tarosay/CanSat2025_Sample/README.md

# CanSat2025_Sample
CanSat 2025 サンプルプログラム 

## CanSatテスト基板の発注

JLCPCBに CanSat2025_04_28.zip を使って基板を発注する方法について、以下の動画で説明しています。

[JLCPCBにCanSatテスト基板を発注する動画はこちら](https://www.youtube.com/watch?v=9X-uCuEG0BU)
