tarosay/CanSat2025_Sample/Documents/ArduinoIDEの事前インストール.pdf

## ArduinoIDEのインストール

㈱ビジュアル・テクノロジー研究所
山本三七男

## 事前にインストールしておく

1.ArduinoサイトからArduinoIDEをダウンロードします

https://www.arduino.cc/en/software

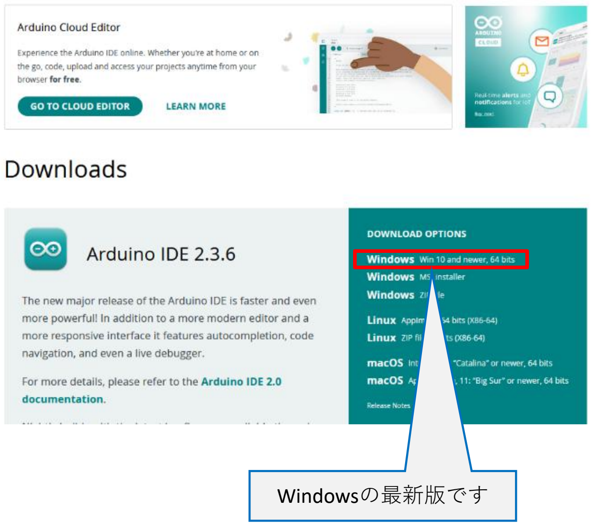
[picture p1: figure]
Windowsの最新版です
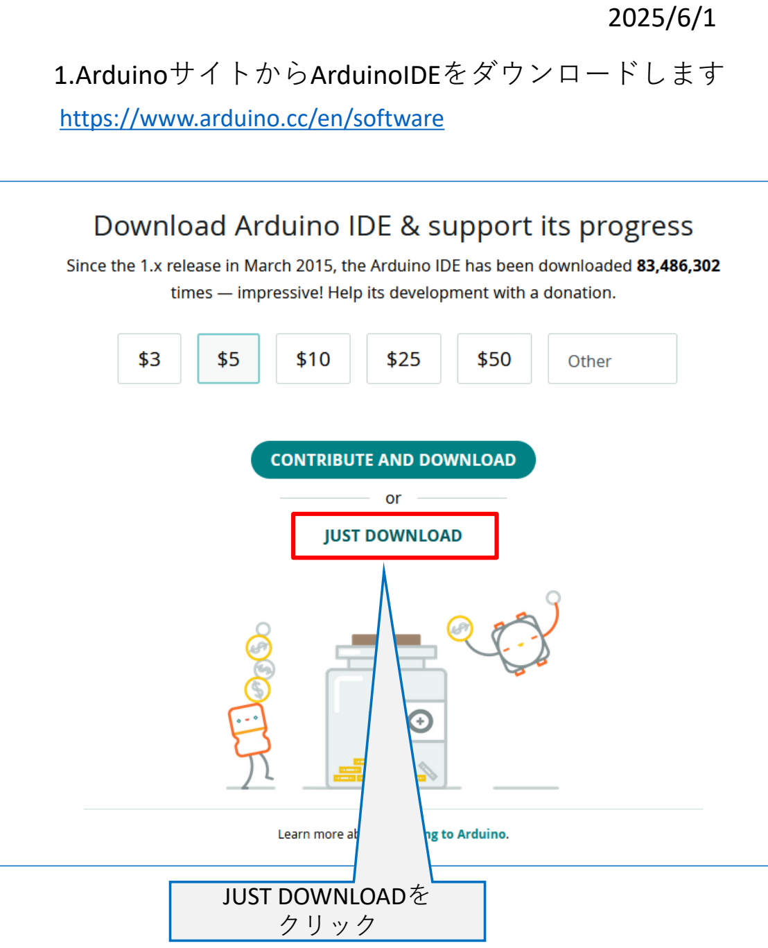
[picture p2: page 3]

JUST DOWNLOADを
クリック

1.ArduinoサイトからArduinoIDEをダウンロードします

https://www.arduino.cc/en/software

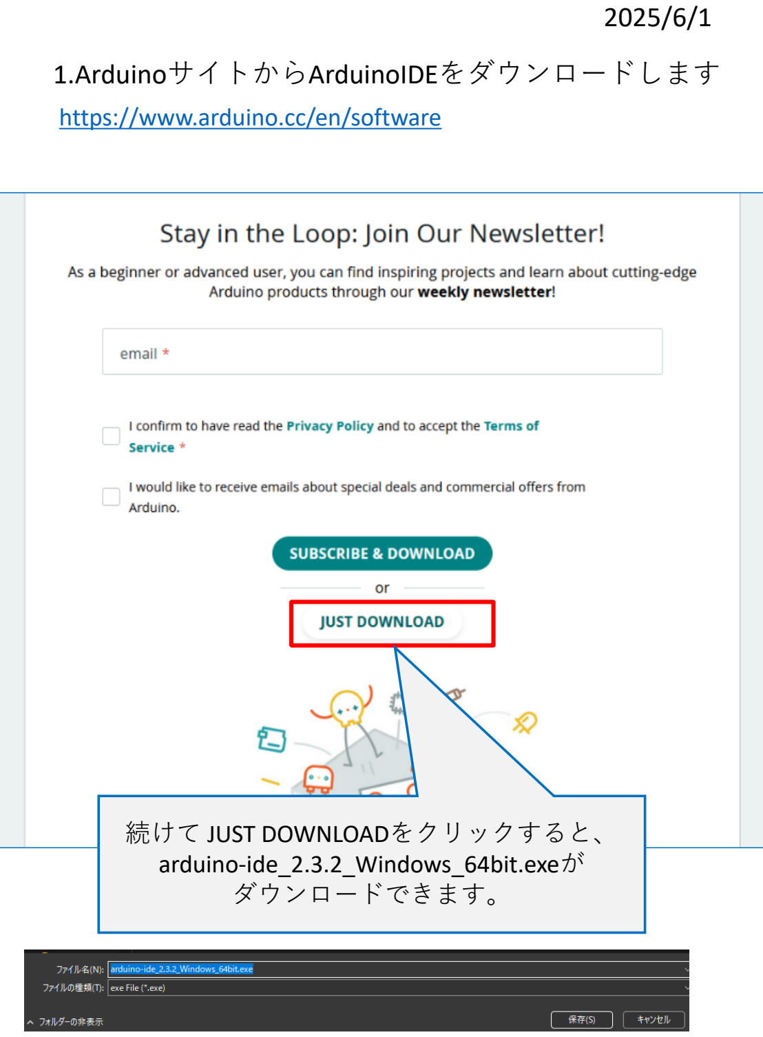
[picture p3: page 4]

続けて JUST DOWNLOADをクリックすると、 arduino-ide_2.3.2_Windows_64bit.exeが ダウンロードできます。

1.ArduinoサイトからArduinoIDEをダウンロードします

https://www.arduino.cc/en/software

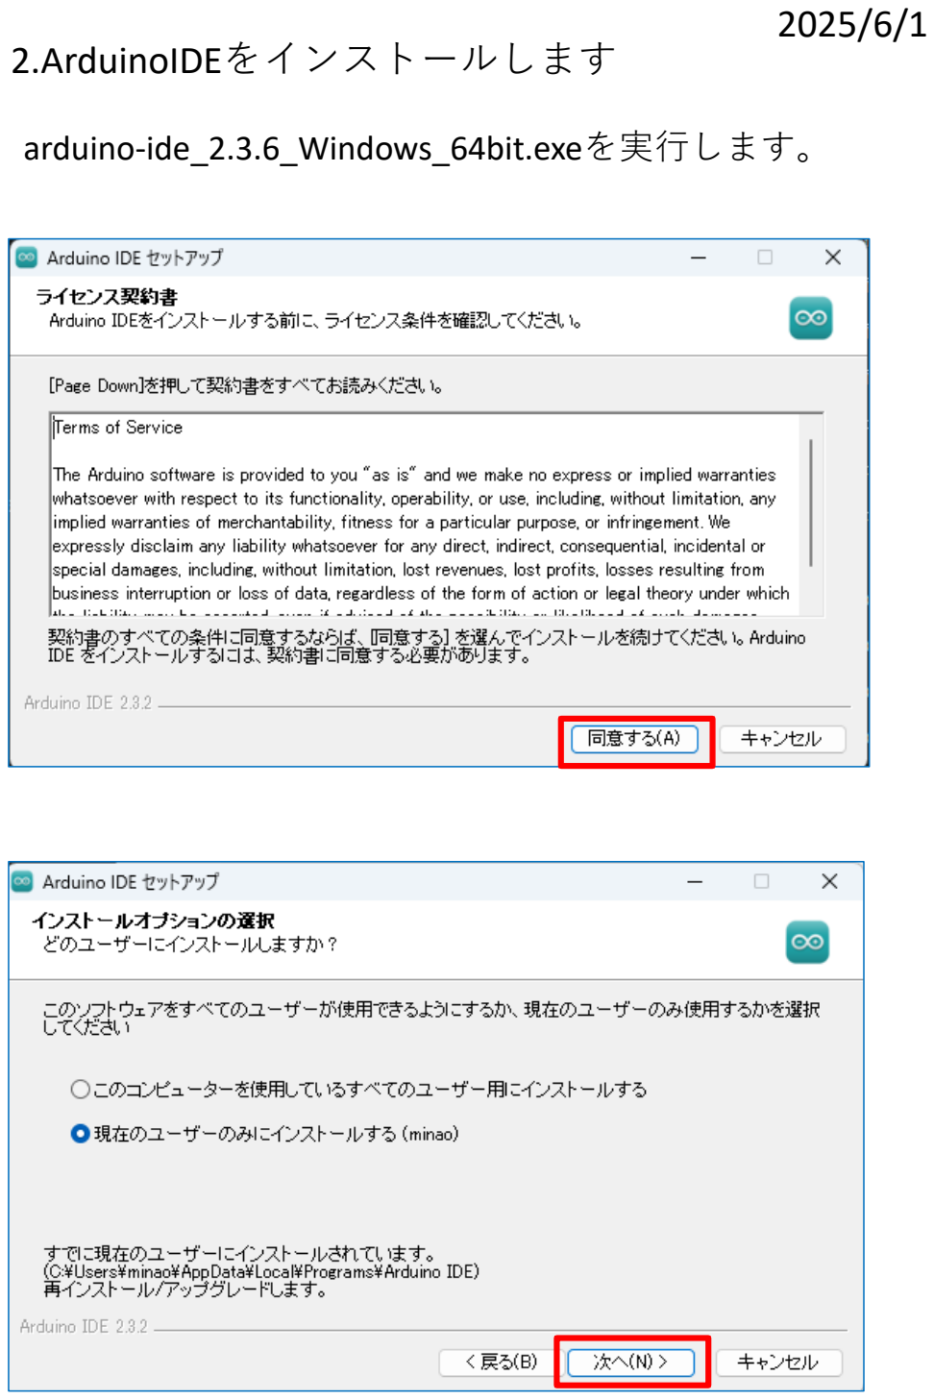
[picture p4: page 5]

2.ArduinoIDEをインストールします

arduino-ide_2.3.6_Windows_64bit.exeを実行します。

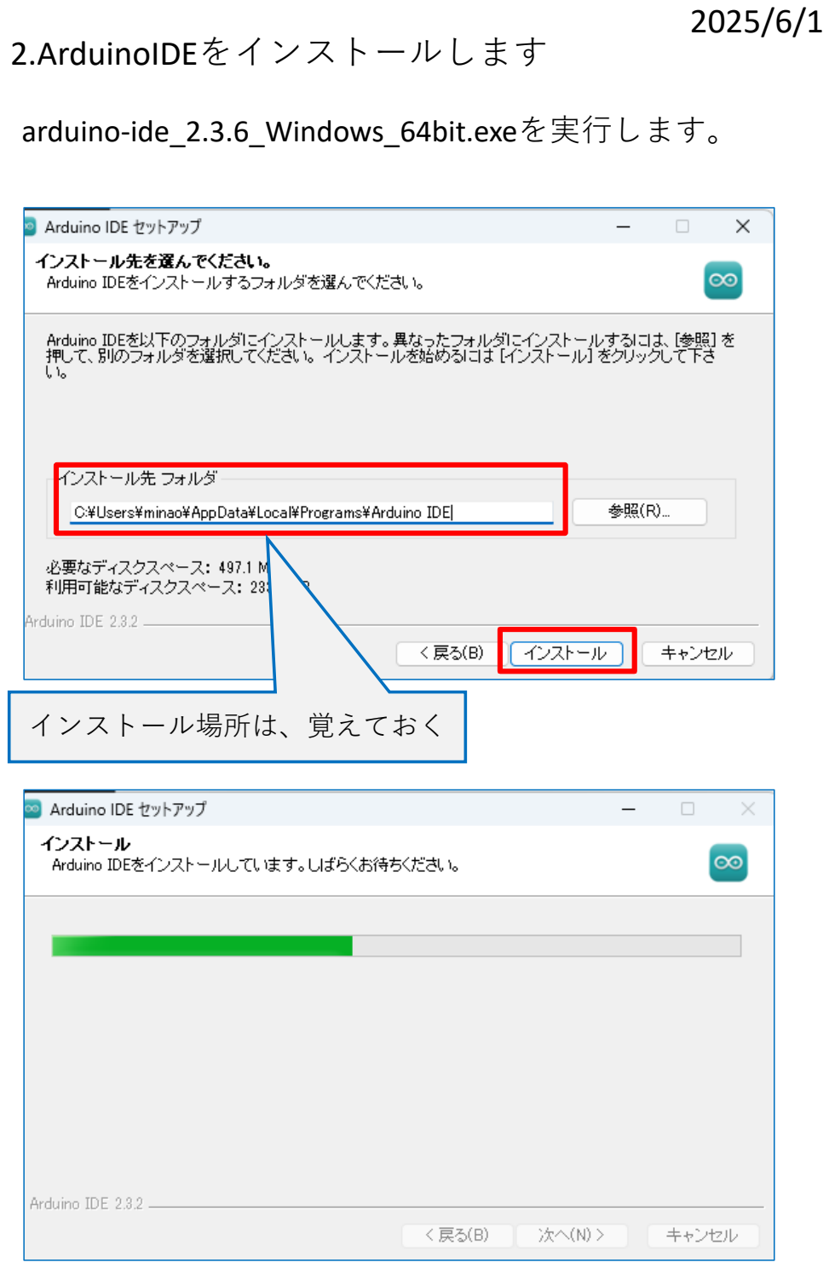
[picture p5: page 6]

2.ArduinoIDEをインストールします

arduino-ide_2.3.6_Windows_64bit.exeを実行します。

インストール場所は、覚えておく

2.ArduinoIDEをインストールします

arduino-ide_2.3.6_Windows_64bit.exeを実行します。

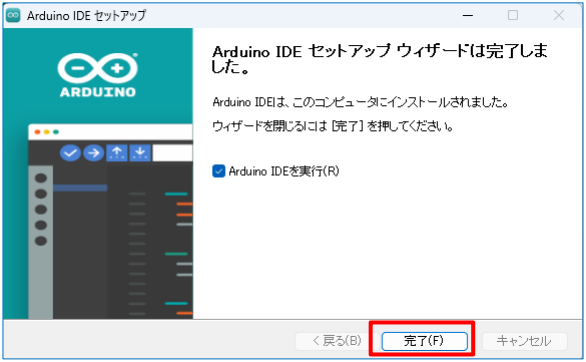
[picture p6: figure]

「完了」を押すと、ArduinoIDEが立ち上がります。

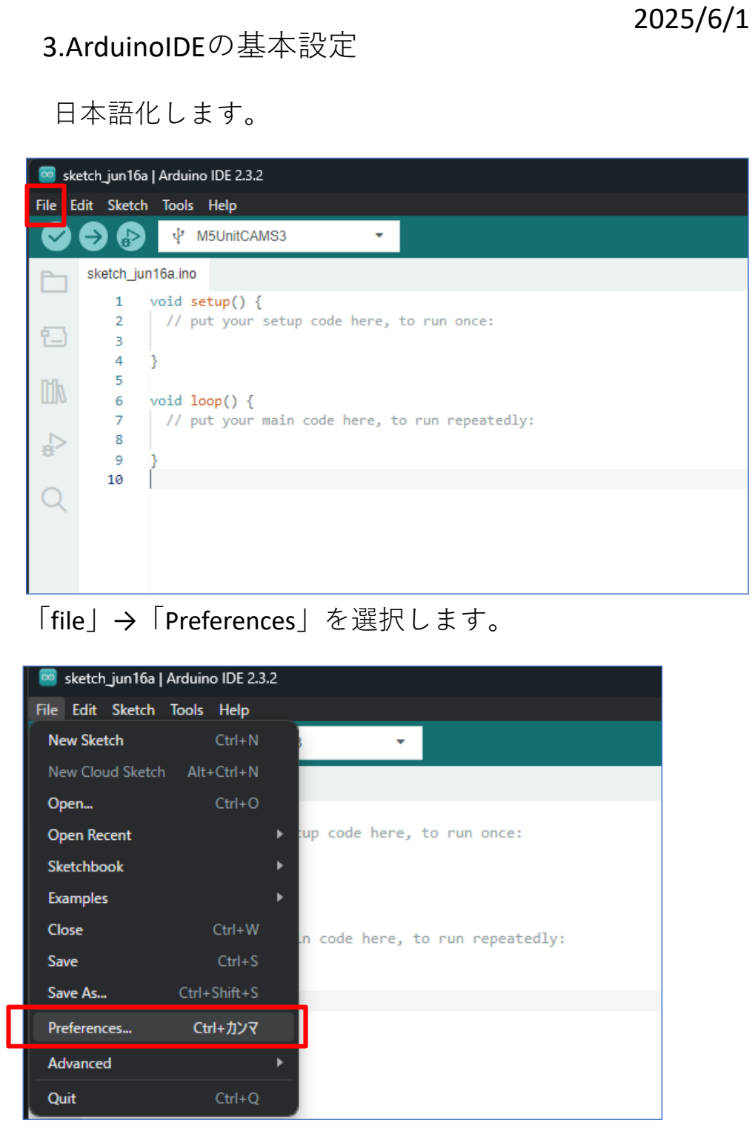
[picture p7: page 8]

3.ArduinoIDEの基本設定

日本語化します。

「file」→「Preferences」を選択します。

3.ArduinoIDEの基本設定

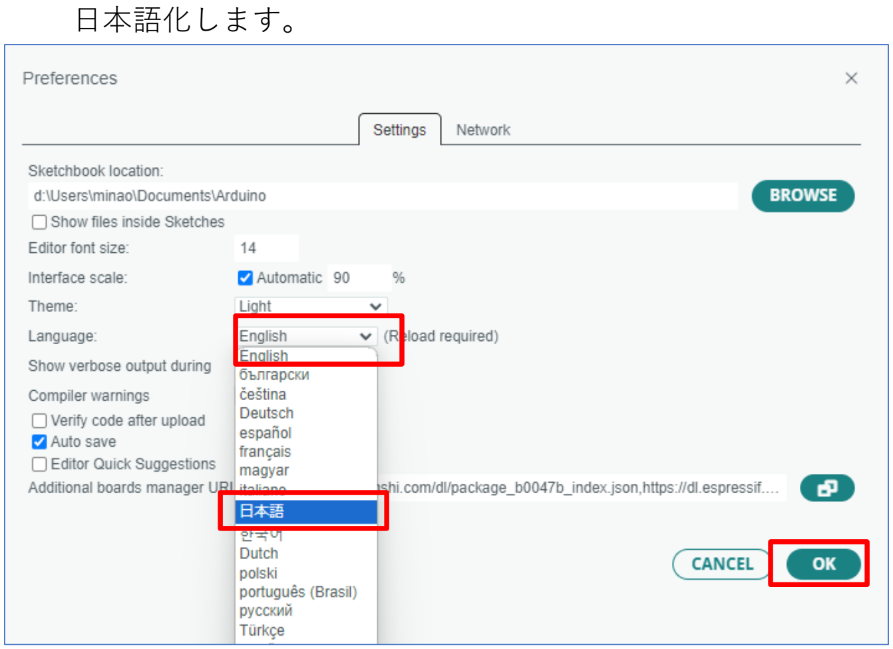
[picture p8: figure]
日本語化します。

「日本語」にして「OK」

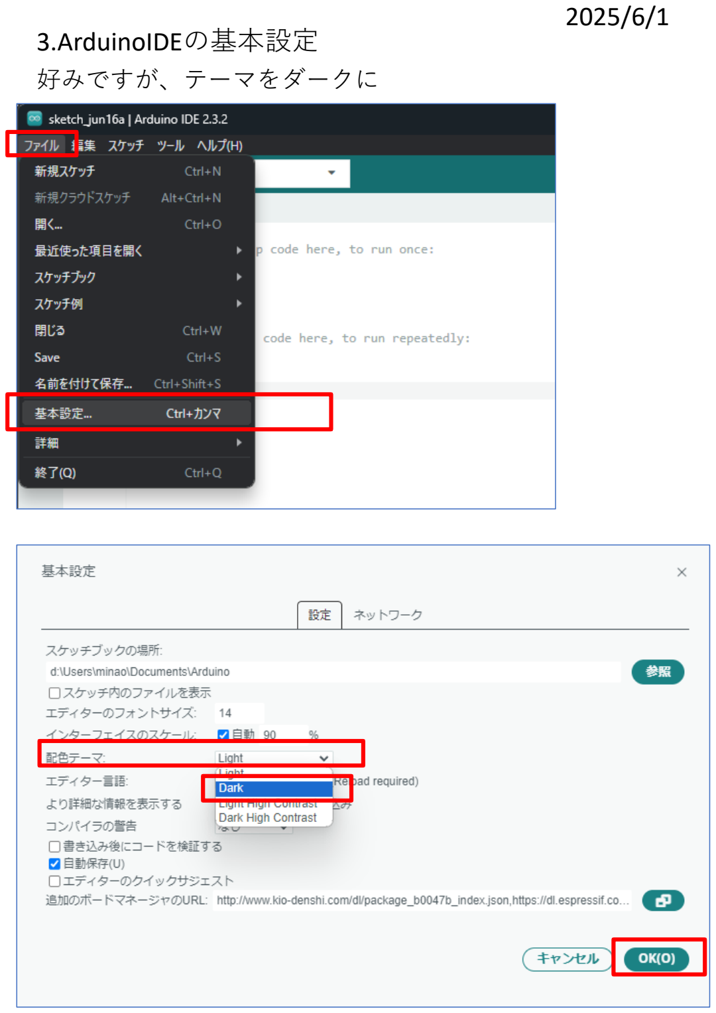
[picture p9: page 10]

3.ArduinoIDEの基本設定
好みですが、テーマをダークに

3.ArduinoIDEの基本設定

より詳細な情報を表示するの「コンパイル」と「書き込
み」にチェックを入れます。

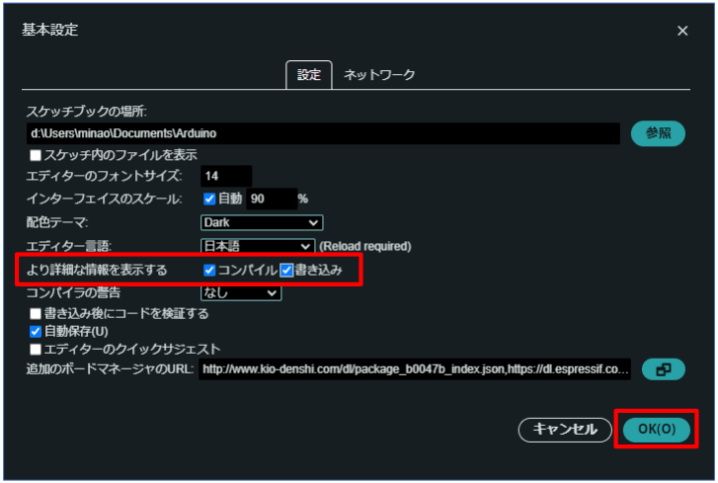
[picture p10: figure]

3.ArduinoIDEの基本設定
追加のボードマネジャのURLに以下を追加する。
https://m5stack.oss-cnshenzhen.aliyuncs.com/resource/arduino/package_m5stack_in dex.json

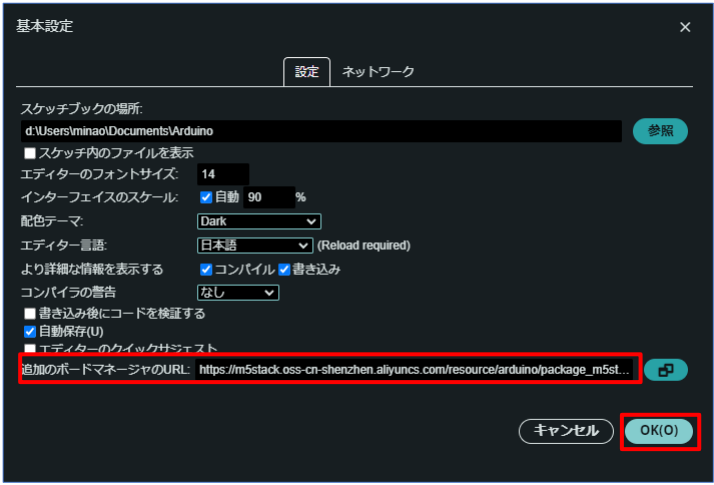
[picture p11: figure]

https://m5stack.oss-cnshenzhen.aliyuncs.com/resource/arduino/package_m5stack_in dex.json

4.M5 Stackシリーズのボードを追加

今回、M5 Stamp S3ボードとM5 Stack CamS3 Unitのプログラ ムを作成するので、M5シリーズのボードを追加します。

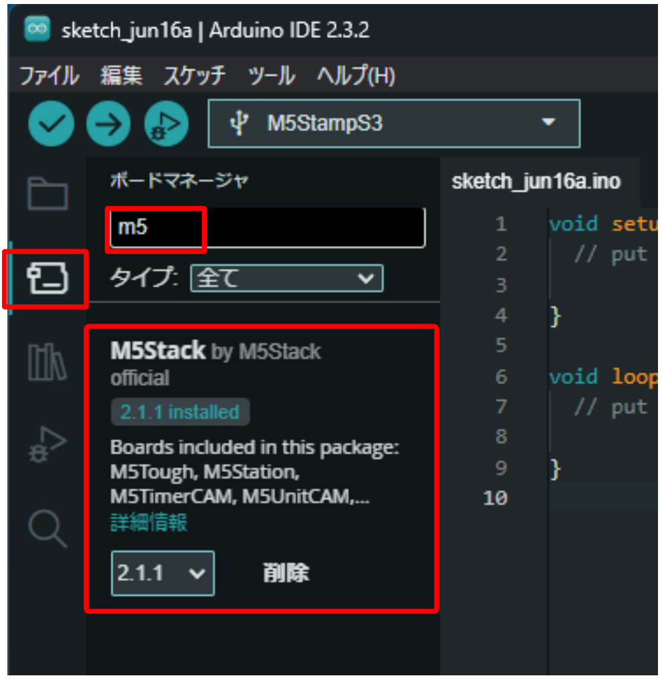
[picture p12: figure]

ボードアイコンを押して、「ボードマネジャ」開く。
検索欄に m5 と打つと、M5Stack by M5Stackが出るので、 「インストール」する。
インストール中にドライバなどのインストール許可が出る が、全て許可する。

5.M5 Stackシリーズのライブラリを追加

今回、M5 Stamp S3ボードとM5 Stack CamS3 Unitのプログラム を作成するので、M5シリーズのライブラリを追加します。

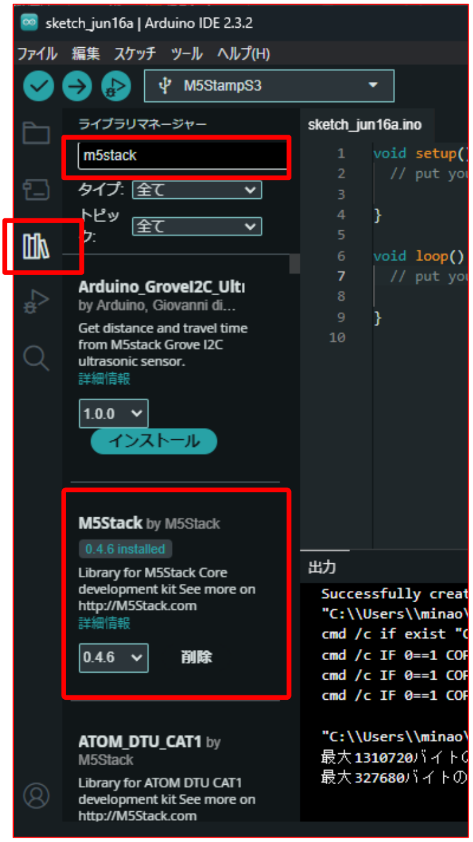
[picture p13: figure]

ライブラリアイコンを押して、「ライブラリマネジャー」 を開く。
検索欄に m5stack と打つと、M5Stack by M5Stackが出るの で、「インストール」する。
