tarosay/CanSat2025_Sample/Documents/M5CamS3Unit-5MPの開発環境設定.pdf

## M5 Cam S3 Unit - 5MPの設定

㈱ビジュアル・テクノロジー研究所
山本三七男

## 事前にインストールしておく

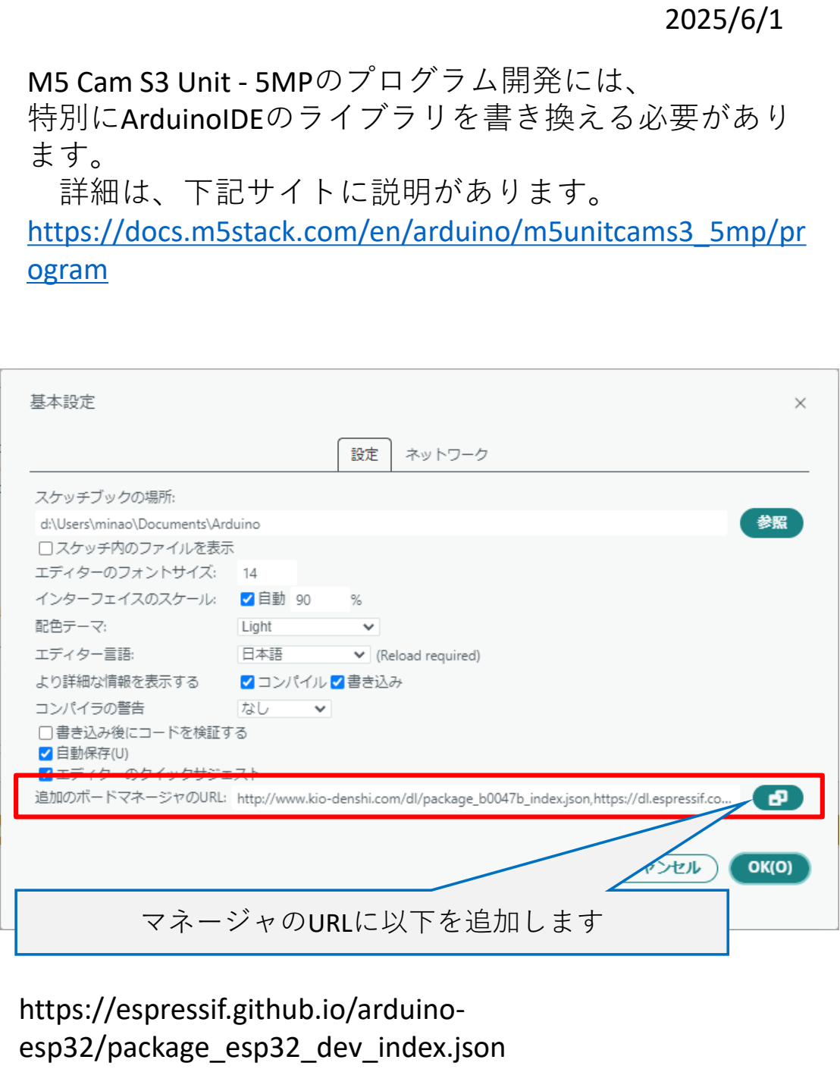
[picture p14: page 2]

M5 Cam S3 Unit - 5MPのプログラム開発には、 特別にArduinoIDEのライブラリを書き換える必要があり ます。
詳細は、下記サイトに説明があります。
https://docs.m5stack.com/en/arduino/m5unitcams3_5mp/pr ogram (https://docs.m5stack.com/en/arduino/m5unitcams3_5mp/program)

マネージャのURLに以下を追加します

https://espressif.github.io/arduinoesp32/package_esp32_dev_index.json

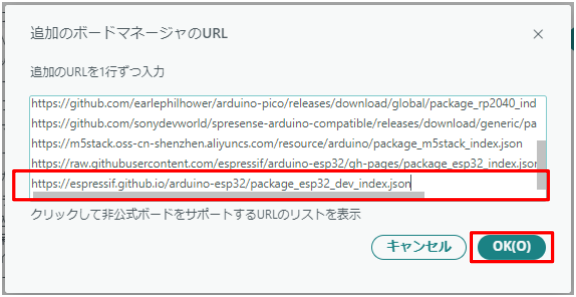
[picture p15: figure]

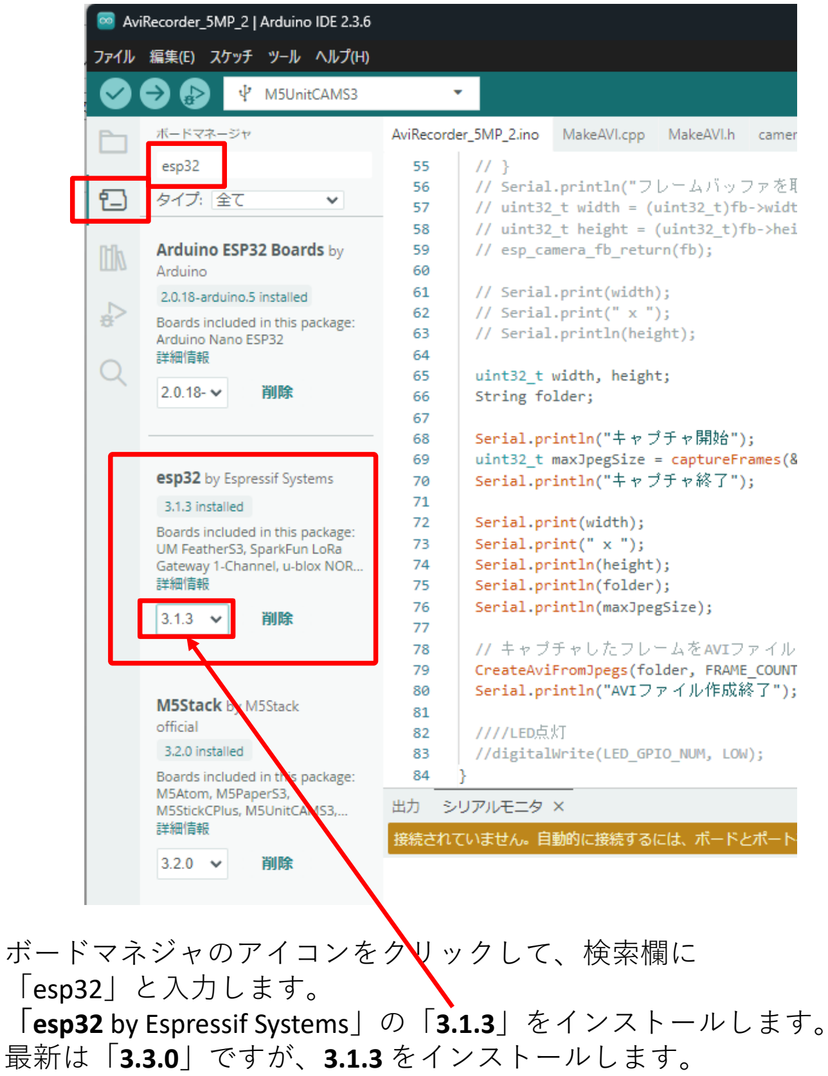
[picture p16: figure]
ボードマネジャのアイコンをクリックして、検索欄に 「esp32」と入力します。 「esp32 by Espressif Systems」の「3.1.3」をインストールします。 最新は「3.3.0」ですが、3.1.3 をインストールします。

libespressif__esp32-camera.a は、下記のフォルダに上書きコ ピーします。
C:¥Users¥[UserName]¥AppData¥Local¥Arduino15¥packages¥esp32 ¥tools¥esp32-arduino-libs¥idf-release_v5.[xxxxxxxxxx]¥esp32s3¥lib¥libespressif__esp32-camera.a

置き換えるファイルは。以下のURLからダウンロードできます。 https://m5stack.oss-cnshenzhen.aliyuncs.com/resource/docs/static/assets/img/arduino/m5cams3_5mp/libespressif__esp32-camera.zip (https://m5stack.oss-cn-shenzhen.aliyuncs.com/resource/docs/static/assets/img/arduino/m5cams3_5mp/libespressif__esp32-camera.zip)

または、以下のURLにもファイルがあります。
https://github.com/tarosay/CanSat2025_Sample/tree/main/M5CamS3Unit_5MP/libespressif__esp32-camera (https://github.com/tarosay/CanSat2025_Sample/tree/main/M5CamS3Unit_5MP/libespressif__esp32-camera)

ESP32ボードのカメラライブラリを強引に置き換えます。

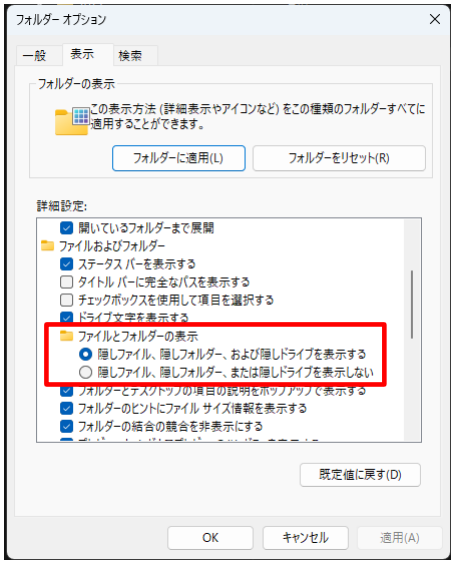
[picture p17: figure]

AppData フォルダは、
フォルダオプションの
「隠しファイル、隠し
フォルダー、および隠し
ドライブを表示する」を
設定すると見えるように
なります。

esp_camera.h、sensor.h は、下記のフォルダに上書きコピーし ます。

C:¥Users¥[UserName]¥AppData¥Local¥Arduino15¥packages¥esp32 ¥tools¥esp32-arduino-libs¥idf-release_v5.[xxxxxxxxx]¥esp32s3¥include¥espressif__esp32-camera¥driver¥include

M5 Cam S3 Unit - 5MPのボードを選びます。 「他のボードとポートを選択」のボード検索欄に
「m5 cam s3」と入力し、出てきた「M5UnitCAMS3 by esp32」を選びます。

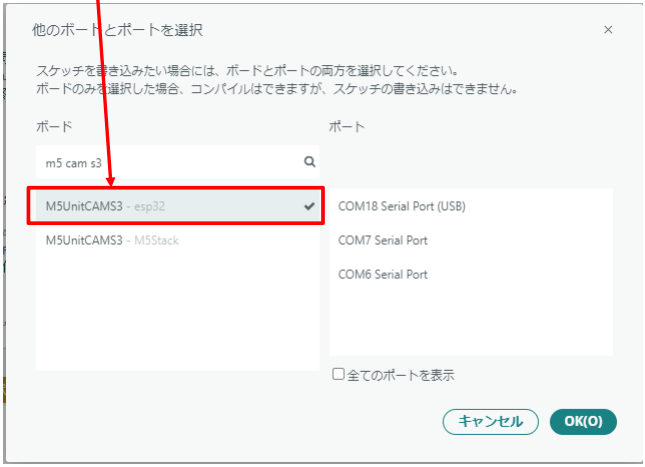
[picture p18: figure]

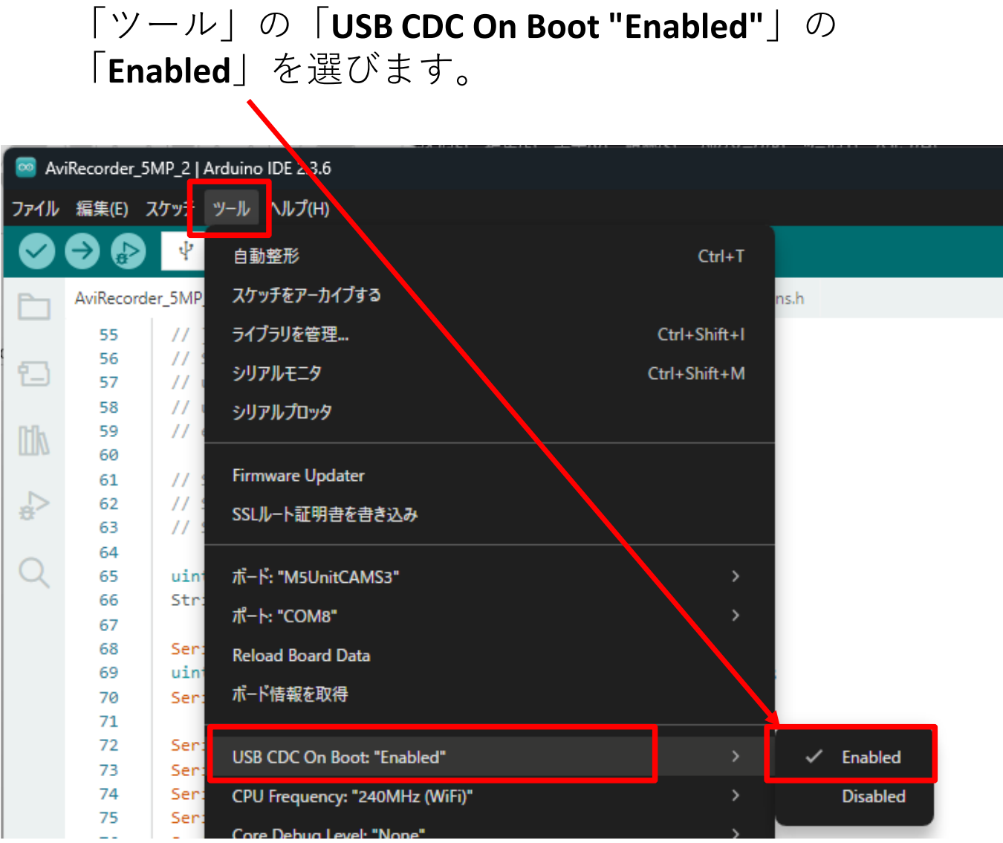
[picture p19: figure]
「ツール」の「USB CDC On Boot "Enabled"」の 「Enabled」を選びます。
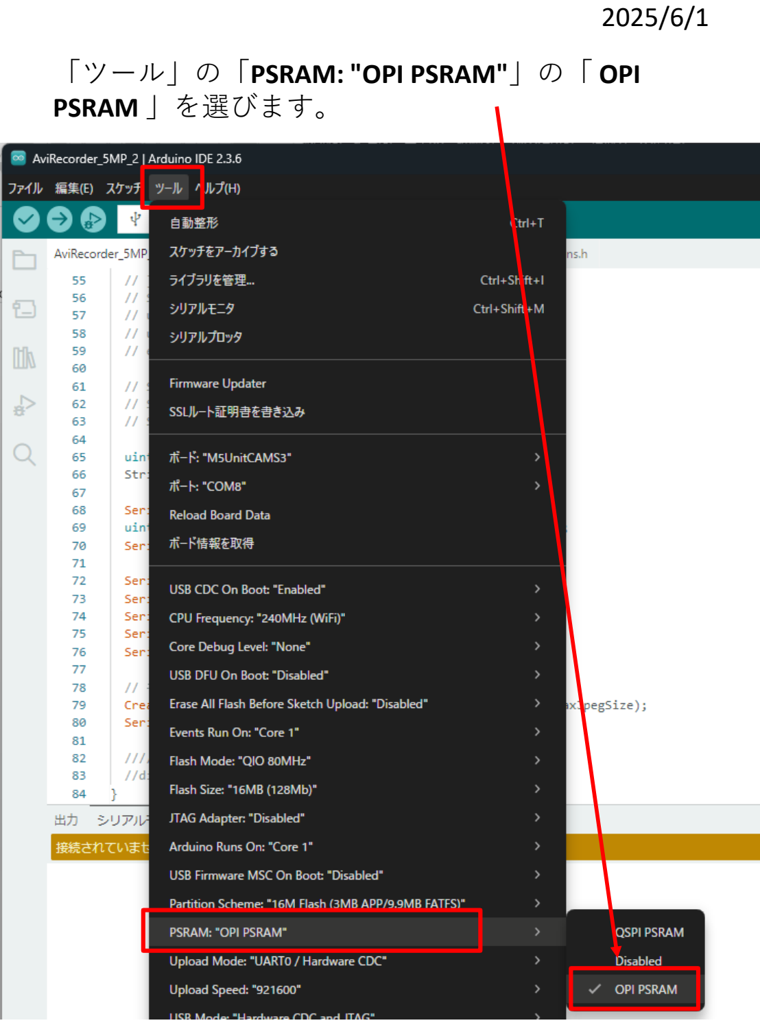
[picture p20: page 9]

「ツール」の「PSRAM: "OPI PSRAM"」の「 OPI PSRAM 」を選びます。

以上で、M5 Cam S3 Unit - 5MP のコンパイルが正常にで きます。
