tarosay/CanSat2025_Sample/3D_Print/ModelRocket_2025_06_08.stl

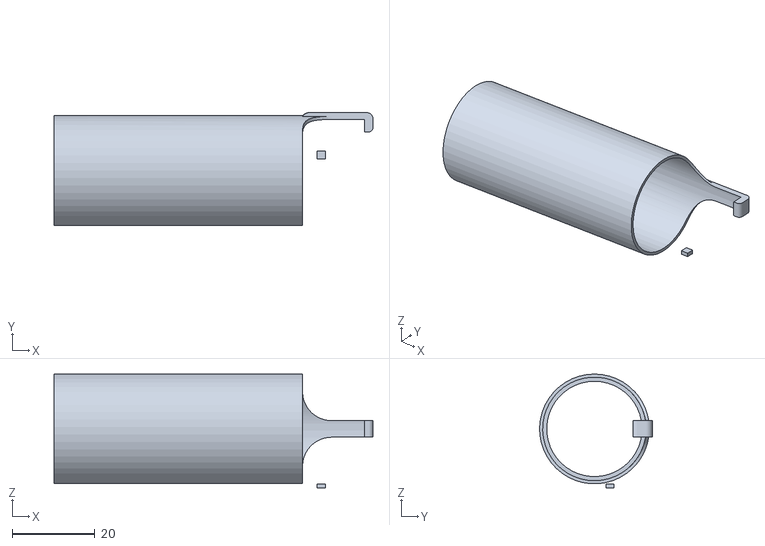
[picture p24: CAD file, 2025-09-04]
3D_Print/ModelRocket_2025_06_08.stl
77.0 x 27.2 x 27.5
