tarosay/CanSat2025_Sample/3D_Print/STL_Data/C11-3_Holder1.stl

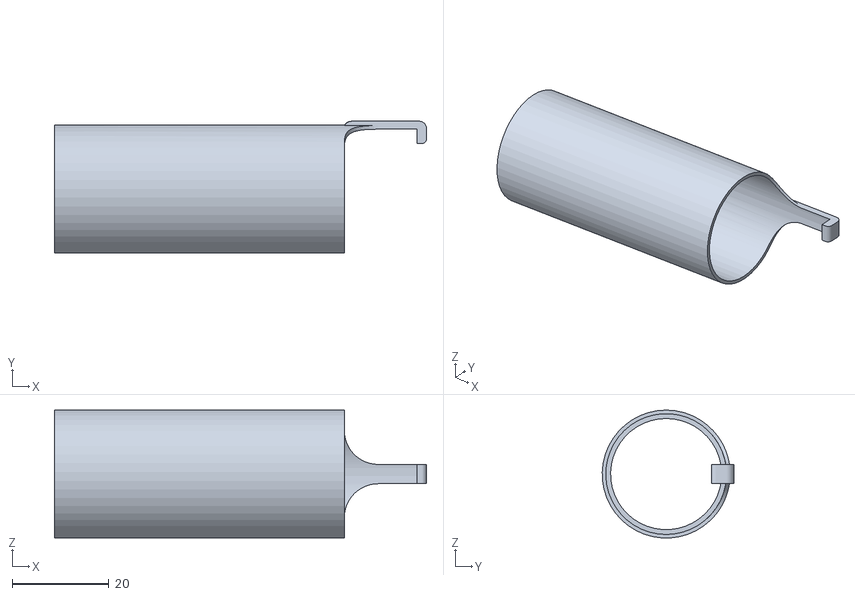
[picture p25: CAD file, 2025-06-06]
3D_Print/STL_Data/C11-3_Holder1.stl
77.0 x 27.2 x 26.5
