tarosay/CanSat2025_Sample/Schematic/CanSat2025_04_28/CanSat2025_04_28.dxf

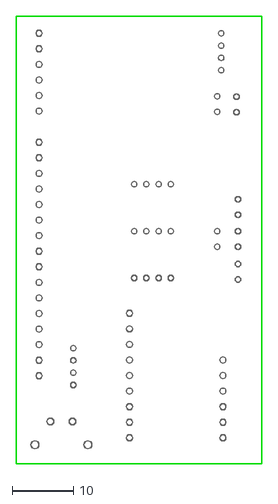
[picture p26: CAD file, 2025-05-15]
Schematic/CanSat2025_04_28/CanSat2025_04_28.dxf
40.0 x 73.0
