tarosay/CanSat2025_Sample/3D_Print/ModelRocket_2025_08_16.stl

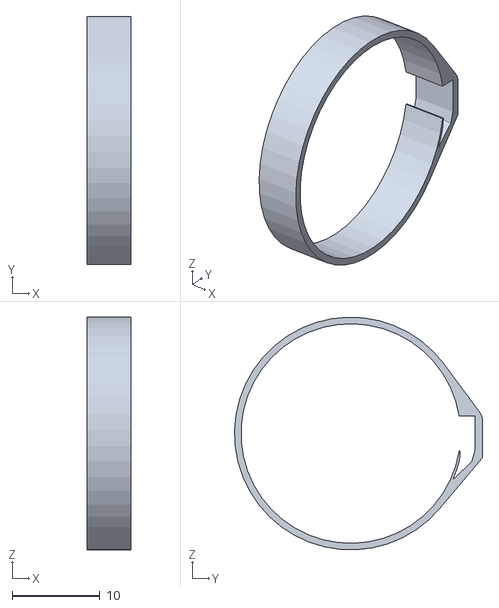
[picture p27: CAD file, 2025-09-04]
3D_Print/ModelRocket_2025_08_16.stl
5.00 x 28.2 x 26.5
