tarosay/CanSat2025_Sample/3D_Print/STL_Data/C11-3_Holder2.stl

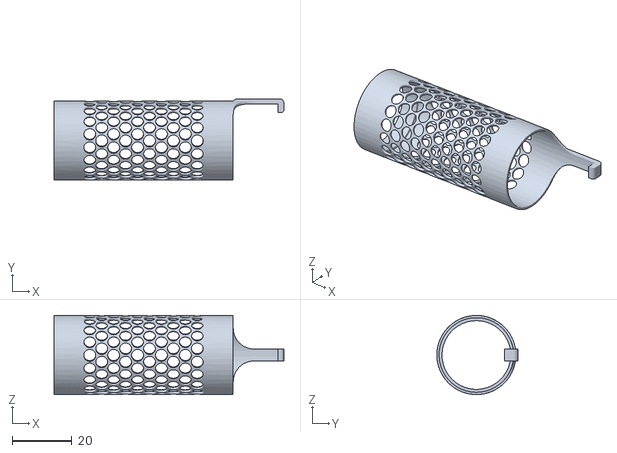
[picture p28: CAD file, 2025-06-06]
3D_Print/STL_Data/C11-3_Holder2.stl
77.0 x 27.2 x 26.5
