tarosay/CanSat2025_Sample/3D_Print/STL_Data/CanSat2025_Cap.stl

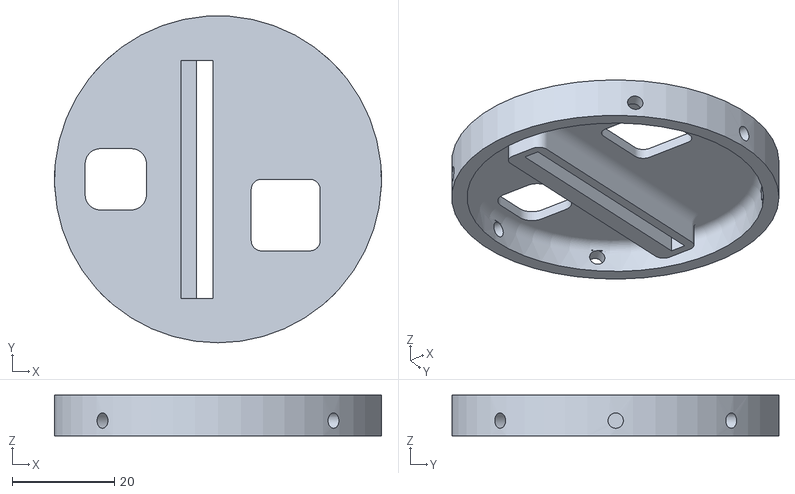
[picture p29: CAD file, 2025-06-01]
3D_Print/STL_Data/CanSat2025_Cap.stl
64.0 x 63.9 x 8.00
