tarosay/CanSat2025_Sample/3D_Print/rocketEngine_2.DXF

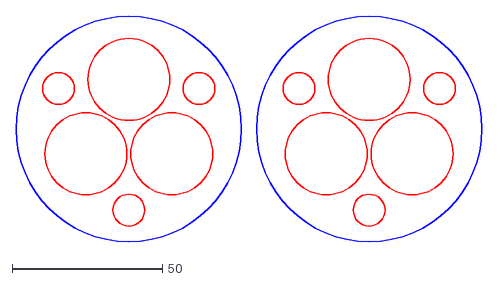
[picture p30: CAD file, 2025-08-05]
3D_Print/rocketEngine_2.DXF
155.0 x 75.0
