tarosay/CanSat2025_Sample/3D_Print/STL_Data/CanSat2025_Plate.stl

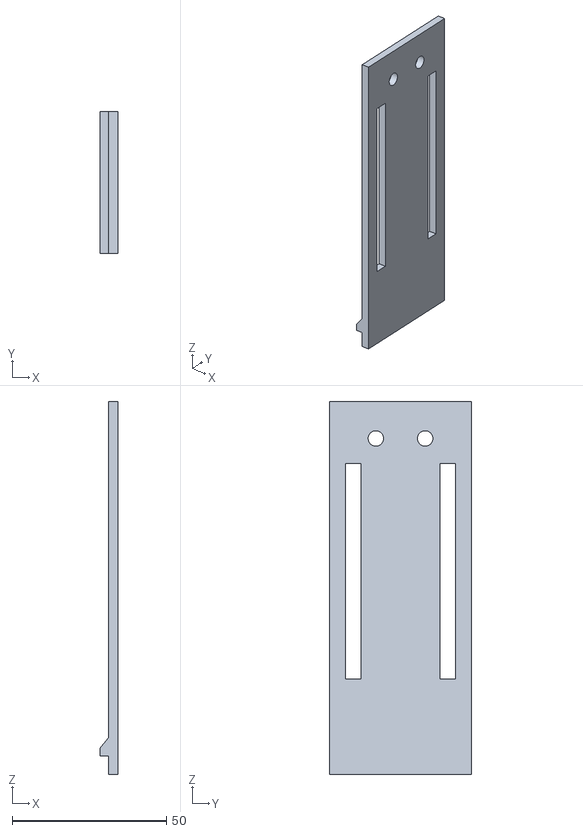
[picture p31: CAD file, 2025-06-01]
3D_Print/STL_Data/CanSat2025_Plate.stl
5.75 x 46.0 x 121.0
