tarosay/CanSat2025_Sample/(list of files, cad)

Other CAD files:
3D_Print/ModelRocket1.stl
3D_Print/ModelRocket_mesh.stl
