tarosay/CanSat2025_Sample/3D_Print/モデルロケット製作に使用教材.pdf

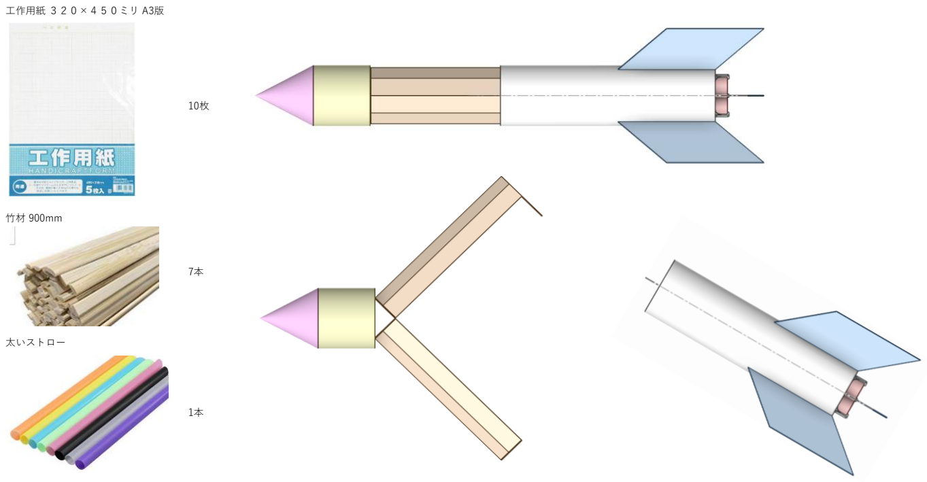
[picture p32: page 1]

工作用紙 ３２０×４５０ミリ A3版

10枚

竹材 900mm

7本

太いストロー

1本

ワイドゴムバンド

2本

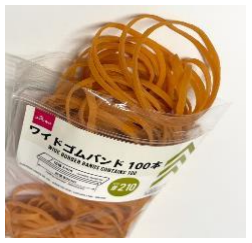
[picture p33: figure]

工作用ボンド

1～2本

コーナン オリジナル PROACT アルミ
テープ　つや無　５０ｍｍ×１０ｍ

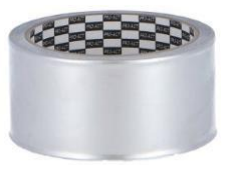
[picture p34: figure]

1つ

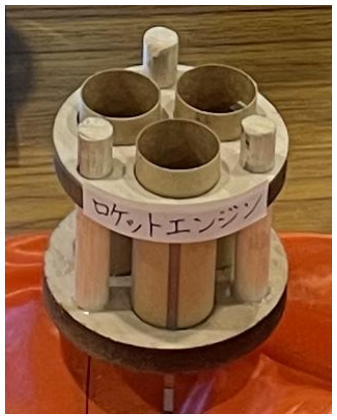
[picture p35: figure]

エンジンフック　標準サイズのエンジ
ン EF1824-3
3本 | http://www.bekkoame.ne.jp/~v2rocket/page006.html

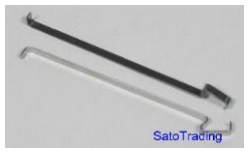
[picture p36: figure]

24mmエンジン用ホルダー 10本入り
1200円　EH2470
3本 | http://www.bekkoame.ne.jp/~v2rocket/page006.html

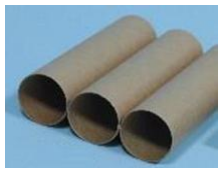
[picture p37: figure]

10mm厚のバルサ板 幅80mm 長さ
600mm
1枚 | モデルロケッツエンジンのマウント用材

5mm厚のバルサ板 幅80mm 長さ
600mm
1枚 | モデルロケッツエンジンのマウント用材

バルサ丸棒　直径10ｍｍ×600ｍｍ

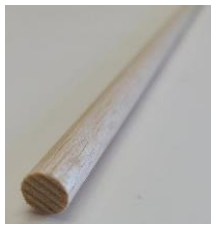
[picture p38: figure]

1本 | モデルロケッツエンジンのマウント用材

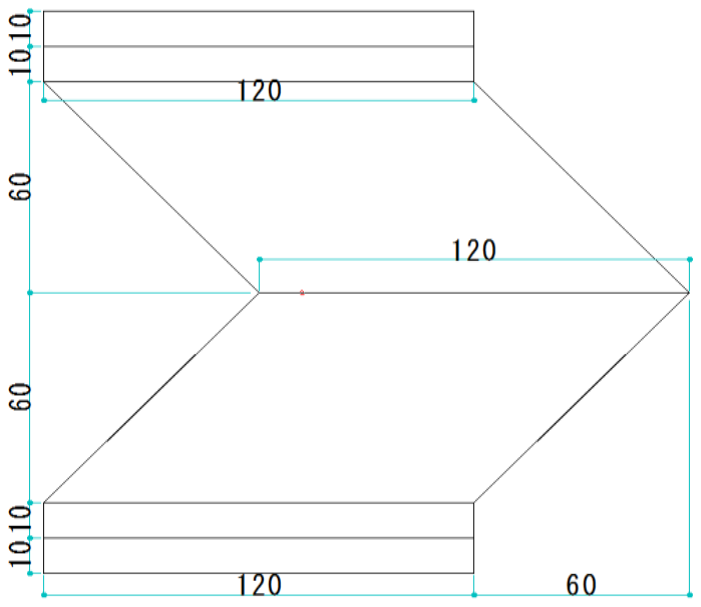
[picture p39: figure]
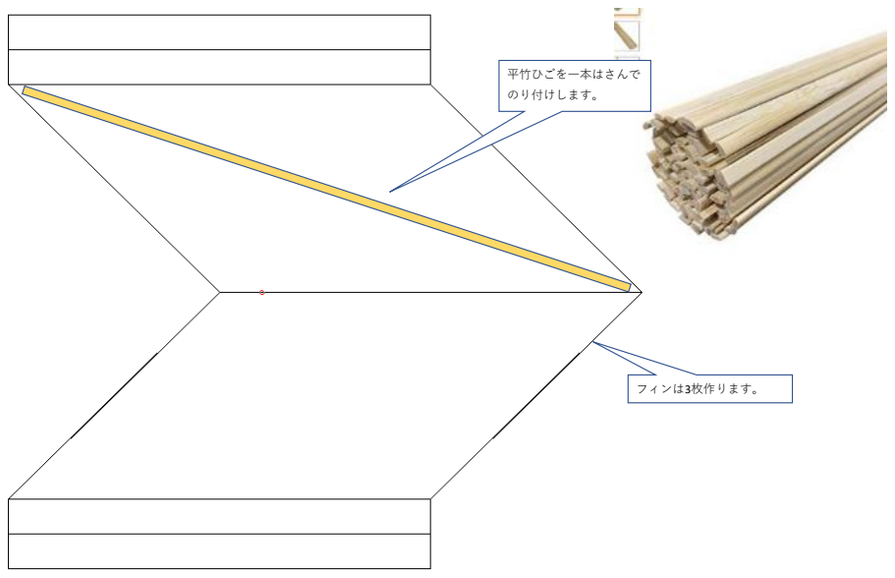
[picture p40: figure]
平竹ひごを一本はさんで; のり付けします。; フィンは3枚作ります。
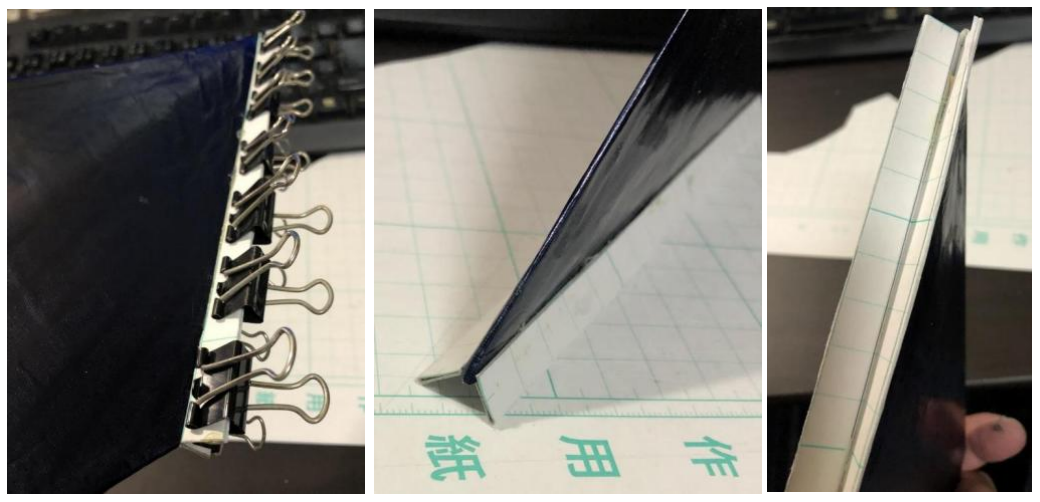
[picture p41: figure]

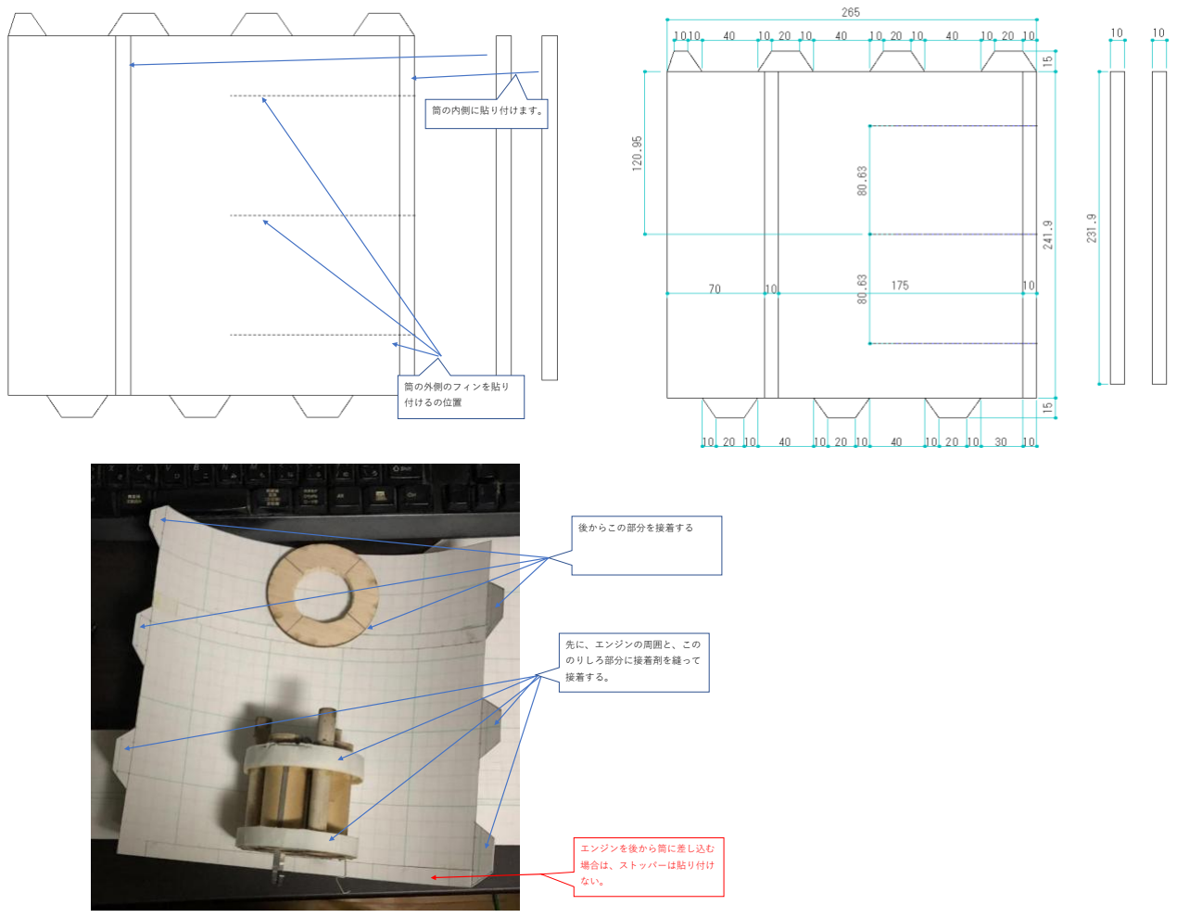
[picture p42: figure]
筒の内側に貼り付けます。; 筒の外側のフィンを貼り; 付けるの位置; 先に、エンジンの周囲と、この; のりしろ部分に接着剤を縫って; 接着する。; 後からこの部分を接着する; エンジンを後から筒に差し込む; 場合は、ストッパーは貼り付け

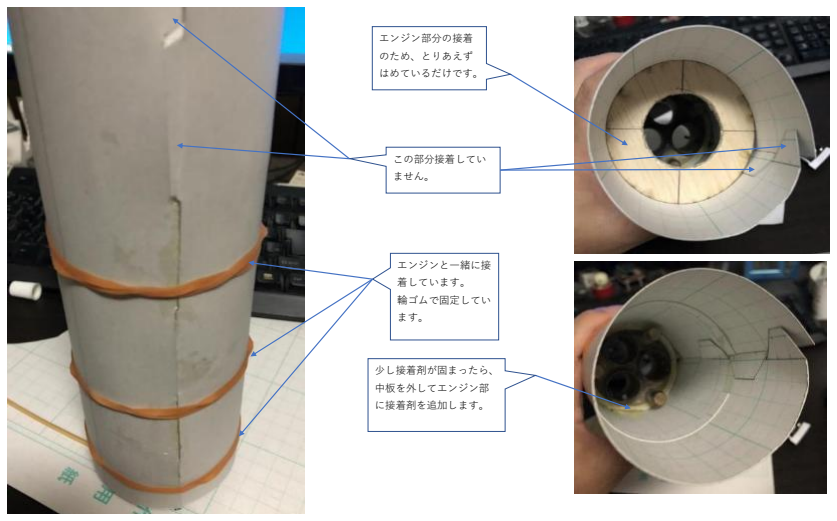
[picture p43: figure]
この部分接着してい; ません。; エンジンと一緒に接; 着しています。; 輪ゴムで固定してい; エンジン部分の接着; のため、とりあえず; はめているだけです。; 少し接着剤が固まったら、; 中板を外してエンジン部; に接着剤を追加します。

筒ののり代も貼り合わせます。

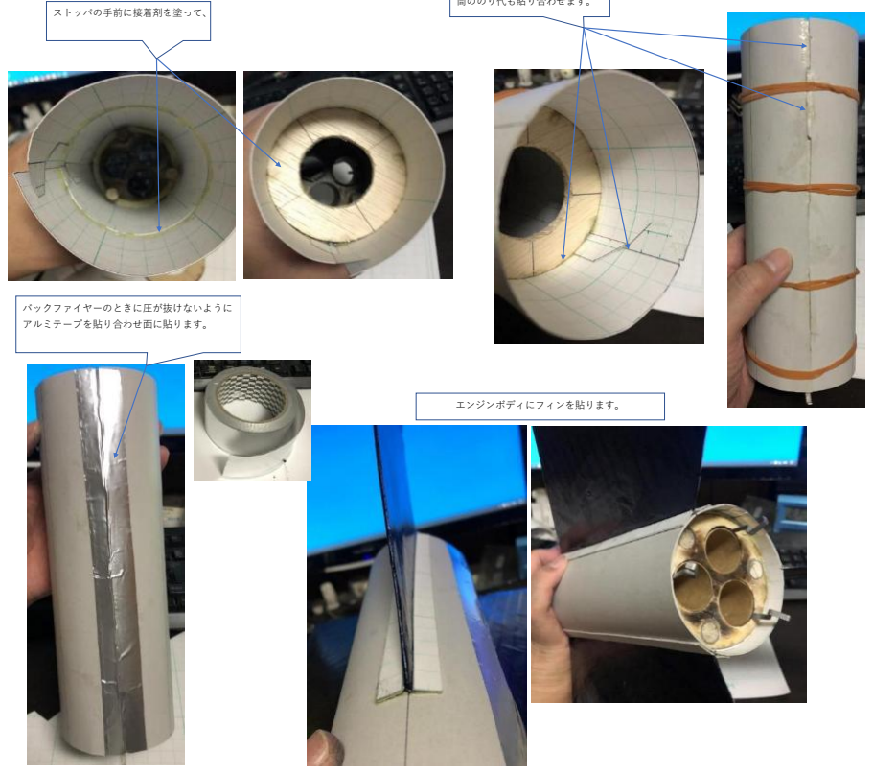
[picture p44: figure]
ストッパの手前に接着剤を塗って、; バックファイヤーのときに圧が抜けないように; アルミテープを貼り合わせ面に貼ります。; エンジンボディにフィンを貼ります。
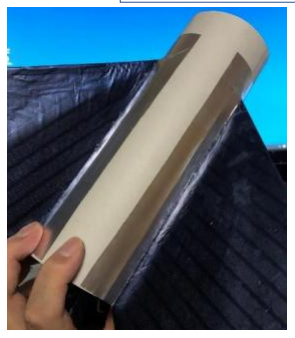
[picture p45: figure]

アルミテープで補強してみました。

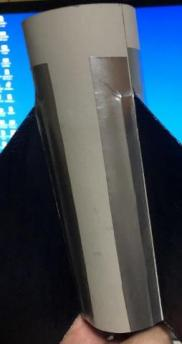
[picture p46: figure]
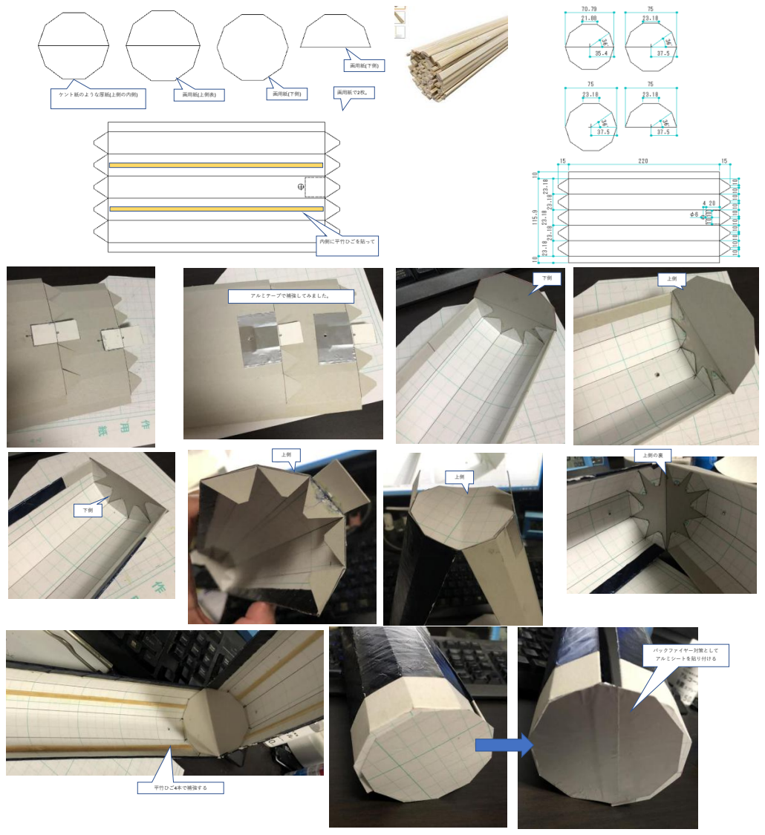
[picture p47: page 9]
ケント紙のような厚紙(上側の内側); 画用紙(上側表); 画用紙で2枚。; 内側に平竹ひごを貼って; アルミテープで補強してみました。; 画用紙(下側); 上側の裏; バックファイヤー対策として; アルミシートを貼り付ける; 平竹ひご4本で補強する

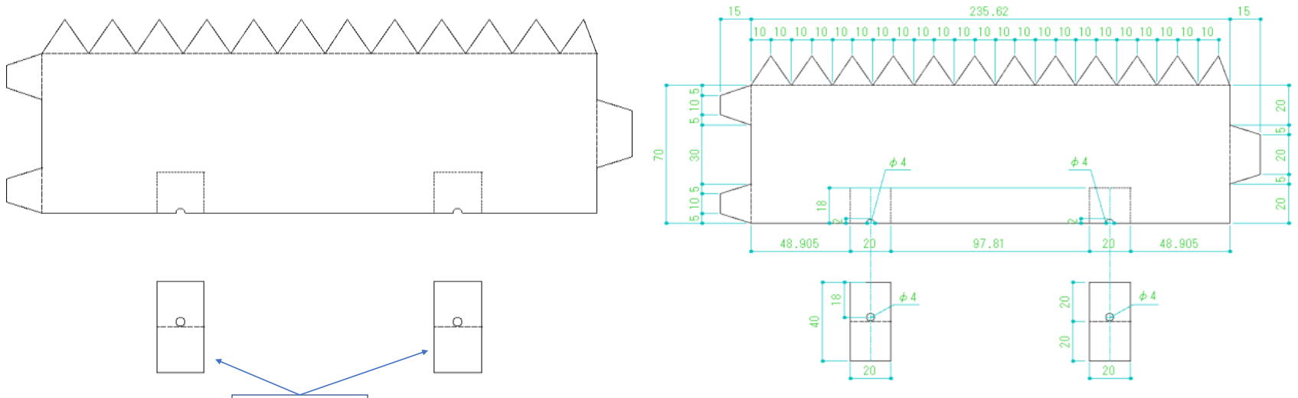
[picture p48: figure]
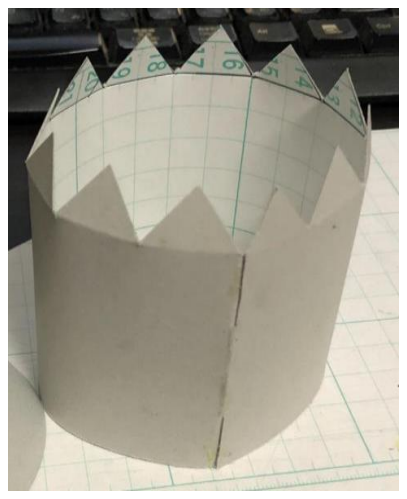
[picture p49: figure]

ケント紙のような厚紙で

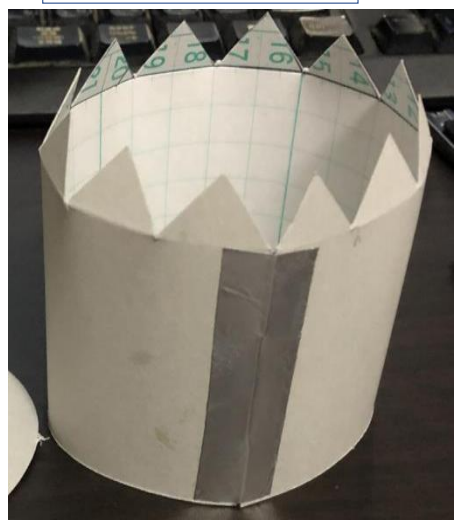
[picture p50: figure]

アルミテープで補強してみました。

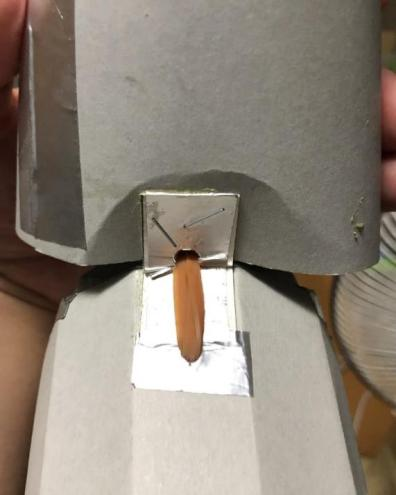
[picture p51: figure]
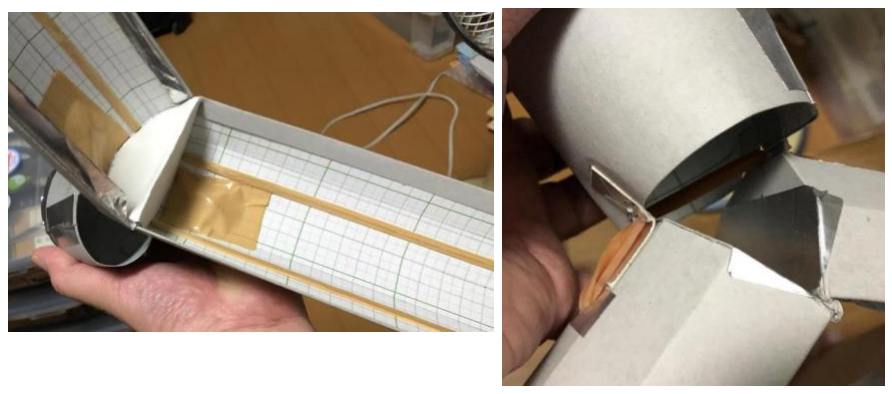
[picture p52: figure]

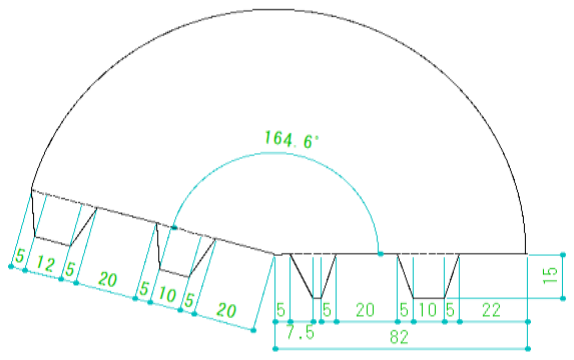
[picture p53: figure]

235.62
82 515.2212
164.6345

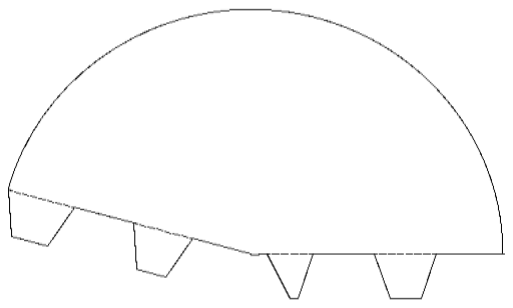
[picture p54: figure]
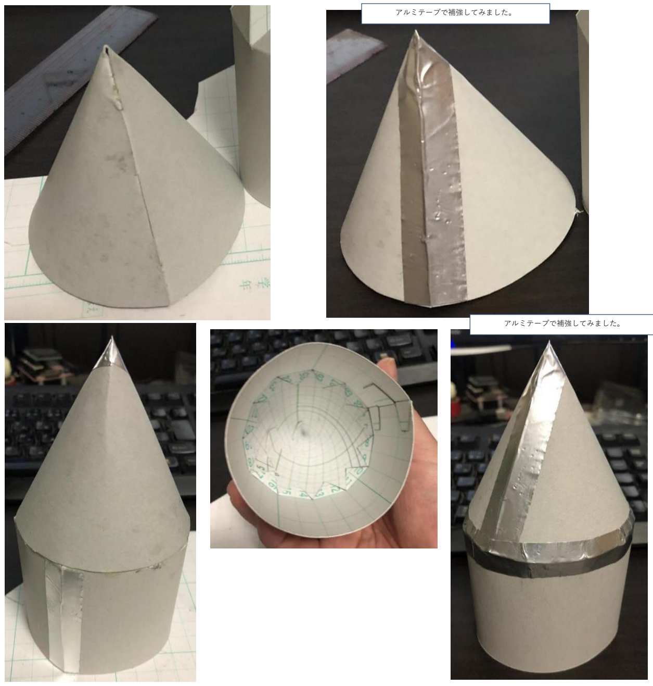
[picture p55: figure]
アルミテープで補強してみました。
