tarosay/CanSat2025_Sample/Schematic/CanSat2025_05_06 - PCB.pdf

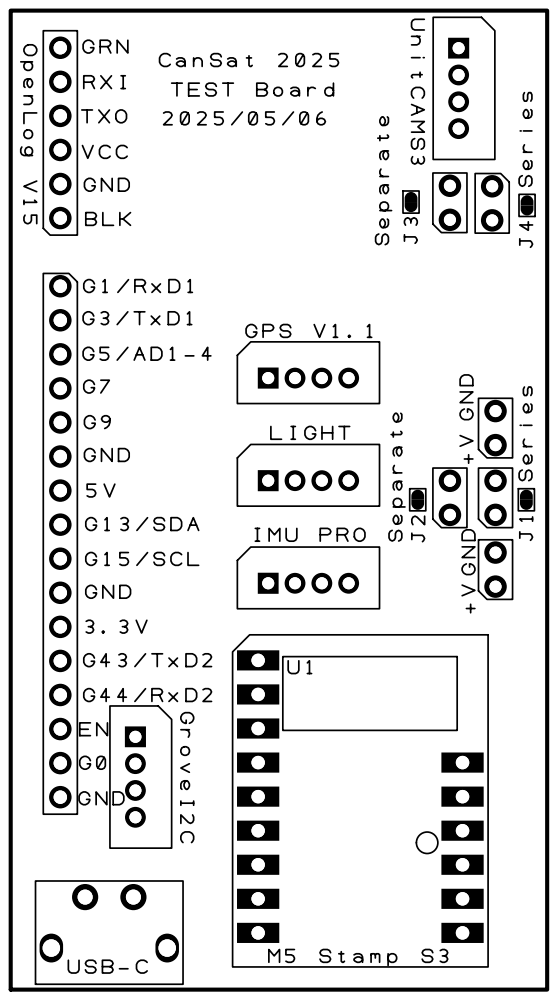
[picture p56: page 1]
