tarosay/CanSat2025_Sample/Schematic/CanSat2025_05_06 - Schematic.pdf

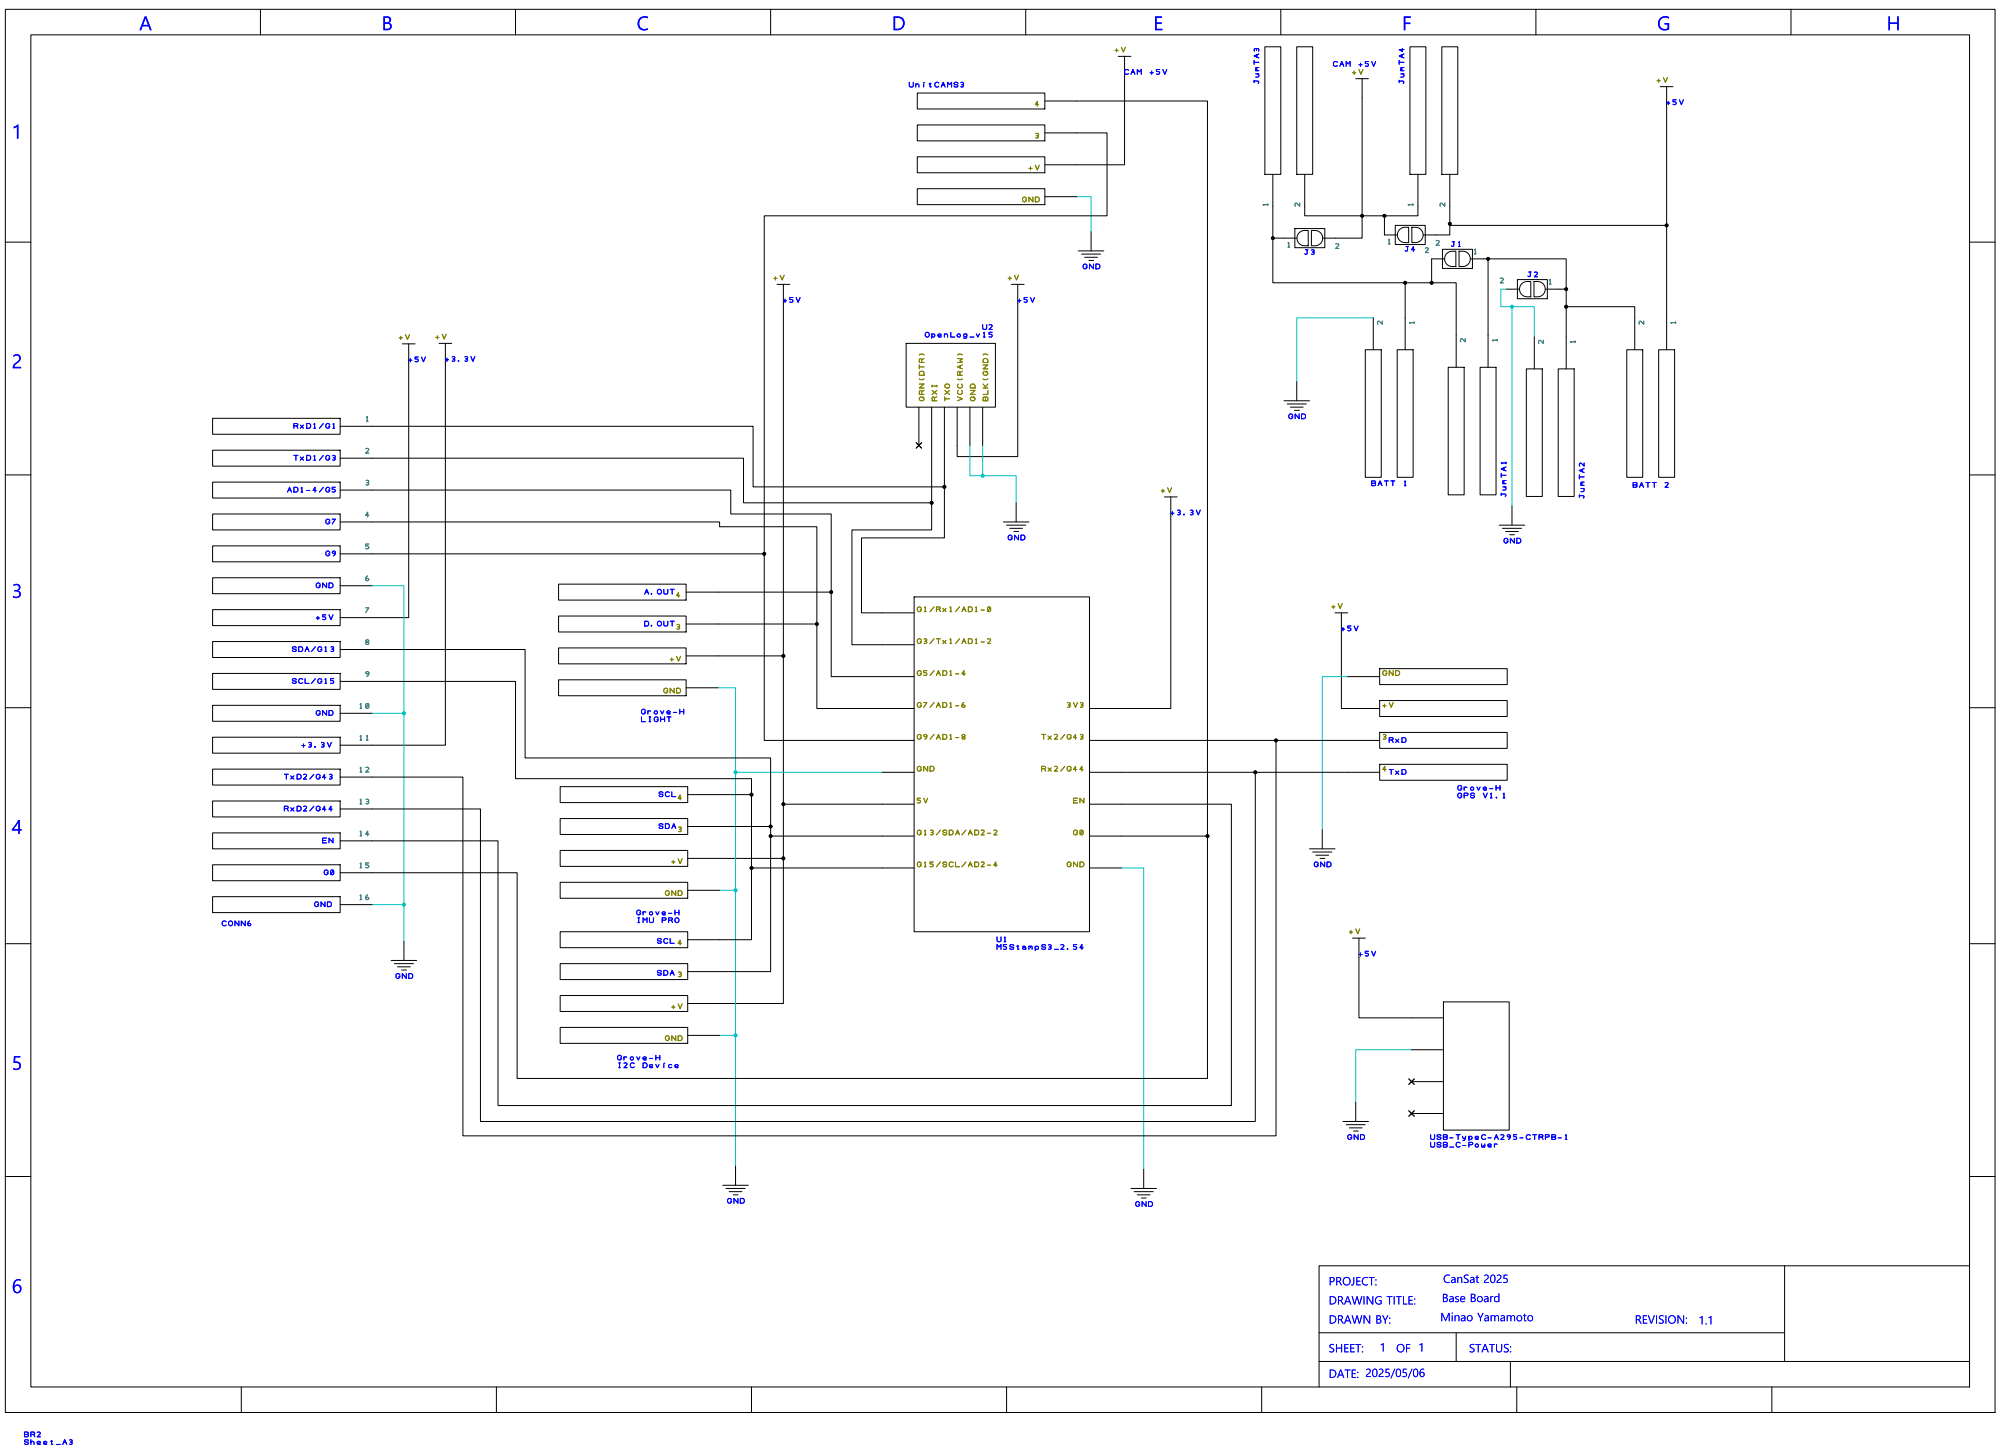
[picture p57: page 1]
