tarosay/CanSat2025_Sample/(list of files, drawings)

Other design files:
Schematic/CanSat2025_04_14.pcb
Schematic/CanSat2025_04_15.pcb
Schematic/CanSat2025_04_28/CanSat2025_04_28.pcb
Schematic/CanSat2025_05_06.pcb
Schematic/CanSat2025_05_15.pcb
