tarosay/CanSat2025_Sample/M5Stamp_S3/BMI270_8G_Sample/BMI270_8G_Sample.ino

#include <Wire.h>
#include "SparkFun_BMI270_Arduino_Library.h"

// Create a new sensor object
BMI270 imu;

// I2C address selection
uint8_t i2cAddress = BMI2_I2C_PRIM_ADDR;  // 0x68
//uint8_t i2cAddress = BMI2_I2C_SEC_ADDR; // 0x69

void setup() {
  // Start serial
  Serial.begin(115200);
  Serial.println("BMI270 Example 4 - Filtering");

  // Initialize the I2C library
  Wire.begin();

  // Check if sensor is connected and initialize
  // Address is optional (defaults to 0x68)
  while (imu.beginI2C(i2cAddress) != BMI2_OK) {
    // Not connected, inform user
    Serial.println("Error: BMI270 not connected, check wiring and I2C address!");

    // Wait a bit to see if connection is established
    delay(1000);
  }

  Serial.println("BMI270 connected!");

  // The accelerometer and gyroscope can be configured with multiple settings
  // to reduce the measurement noise. Both sensors have the following settings
  // in common:
  // .range       - Measurement range. Lower values give more resolution, but
  //                doesn't affect noise significantly, and limits the max
  //                measurement before saturating the sensor
  // .odr         - Output data rate in Hz. Lower values result in less noise,
  //                but lower sampling rates.
  // .filter_perf - Filter performance mode. Performance oprtimized mode
  //                results in less noise, but increased power consumption
  // .bwp         - Filter bandwidth parameter. This has several possible
  //                settings that can reduce noise, but cause signal delay
  //
  // Both sensors have different possible values for each setting:
  //
  // Accelerometer values:
  // .range       - 2g to 16g
  // .odr         - Depends on .filter_perf:
  //                  Performance mode: 12.5Hz to 1600Hz
  //                  Power mode:       0.78Hz to 400Hz
  // .bwp         - Depends on .filter_perf:
  //                  Performance mode: Normal, OSR2, OSR4, CIC
  //                  Power mode:       Averaging from 1 to 128 samples
  //
  // Gyroscope values:
  // .range       - 125dps to 2000dps (deg/sec)
  // .ois_range   - 250dps or 2000dps (deg/sec) Only relevant when using OIS,
  //                see datasheet for more info. Defaults to 250dps
  // .odr         - Depends on .filter_perf:
  //                  Performance mode: 25Hz to 3200Hz
  //                  Power mode:       25Hz to 100Hz
  // .bwp         - Normal, OSR2, OSR4, CIC
  // .noise_perf  - Similar to .filter_perf. Performance oprtimized mode
  //                results in less noise, but increased power consumption
  //
  // Note that not all combinations of values are possible. The performance
  // mode restricts which ODR settings can be used, and the ODR restricts some
  // bandwidth parameters. An error code is returned by setConfig, which can
  // be used to determine whether the selected settings are valid.
  int8_t err = BMI2_OK;

  // Set accelerometer config
  bmi2_sens_config accelConfig;
  accelConfig.type = BMI2_ACCEL;
  accelConfig.cfg.acc.odr = BMI2_ACC_ODR_50HZ;
  accelConfig.cfg.acc.bwp = BMI2_ACC_OSR4_AVG1;
  accelConfig.cfg.acc.filter_perf = BMI2_PERF_OPT_MODE;
  accelConfig.cfg.acc.range = BMI2_ACC_RANGE_8G;
  err = imu.setConfig(accelConfig);

  // Set gyroscope config
  bmi2_sens_config gyroConfig;
  gyroConfig.type = BMI2_GYRO;
  gyroConfig.cfg.gyr.odr = BMI2_GYR_ODR_50HZ;
  gyroConfig.cfg.gyr.bwp = BMI2_GYR_OSR4_MODE;
  gyroConfig.cfg.gyr.filter_perf = BMI2_PERF_OPT_MODE;
  gyroConfig.cfg.gyr.ois_range = BMI2_GYR_OIS_250;
  gyroConfig.cfg.gyr.range = BMI2_GYR_RANGE_125;
  gyroConfig.cfg.gyr.noise_perf = BMI2_PERF_OPT_MODE;
  err = imu.setConfig(gyroConfig);

  // Check whether the config settings above were valid
  while (err != BMI2_OK) {
    // Not valid, determine which config was the problem
    if (err == BMI2_E_ACC_INVALID_CFG) {
      Serial.println("Accelerometer config not valid!");
    } else if (err == BMI2_E_GYRO_INVALID_CFG) {
      Serial.println("Gyroscope config not valid!");
    } else if (err == BMI2_E_ACC_GYR_INVALID_CFG) {
      Serial.println("Both configs not valid!");
    } else {
      Serial.print("Unknown error: ");
      Serial.println(err);
    }
    delay(1000);
  }

  Serial.println("Configuration valid! Beginning measurements");
  delay(1000);
}

void loop() {
  // Get measurements from the sensor. This must be called before accessing
  // the sensor data, otherwise it will never update
  imu.getSensorData();

  String log = "";
  log += String(imu.data.accelX) + "," + String(imu.data.accelY) + "," + String(imu.data.accelZ) + ",5,-5";
  //log += String(imu.data.gyroX) + "," + String(imu.data.gyroY) + "," + String(imu.data.gyroZ) + ",500,-500";
  Serial.println(log);

  delay(100);
}
