tarosay/CanSat2025_Sample/(commit log)

2025-05-15 Update Now
    [CanSat2025_04_14.pcb, CanSat2025_04_14.sch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]
2025-06-01 いろいろ追加
    [CanSat2025_05_26-1.stl, CanSat2025_05_26-2.stl, 空力中心の計算.xlsx]
2025-06-04 プログラムと回路図の更新
    [CanSat2025_04_28.pcb, CanSat2025_04_28.sch, CanSat2025_05_06.pcb, CanSat2025_05_06.sch, ~CanSat2025_04_14.pcb, ~CanSat2025_04_14.sch, ~CanSat2025_04_28.pcb, ~CanSat2025_04_28.sch]
2025-06-04 サンプルの整理
2025-06-05 program update
    [partitions.csv]
2025-06-05 資料の追加
2025-06-05 フォルダ間違い修正
2025-06-05 不要なプログラムの整理
2025-06-06 3d stl data added
    [C11-3_Holder1.stl, C11-3_Holder2.stl, CanSat2025_Cap.stl, CanSat2025_Plate.stl]
2025-06-09 Data Update
    [空力中心の計算.xlsx]
2025-06-09 pdfとmp4追加
2025-06-10 加速度のレンジを±8gに設定
2025-06-11 不要なファイルを削除
2025-06-11 Old Gbr data deleted
    [CanSat2025_04_15 - Bottom Copper.gbr, CanSat2025_04_15 - Bottom Solder Mask.gbr, CanSat2025_04_15 - Documentation - コピー.gbr, CanSat2025_04_15 - Drill Ident Drawing - [Through Hole].gbr, CanSat2025_04_15 - Gerber Drill Data - [Through Hole].gbr, CanSat2025_04_15 - NC Drill Data - [Through Hole].drl, CanSat2025_04_15 - Top Copper.gbr, CanSat2025_04_15 - Top Silkscreen.gbr]
2025-08-05 new data added
    [ModelRocket1.stl, ModelRocket_mesh.stl, rocketEngine_2.DXF]
2025-09-04 WavRecoding Update
    [ModelRocket_2025_06_08.stl, ModelRocket_2025_08_16.stl]
